Krasutski/mazda_tape_deck_emulator/(threads)

Thread 2 (2022-06-06):

Does the iPod support work with iPhones?

Shambler2, 2022-06-06:
Hiya,

I wanted to use this to add AuxIn to my 2004 Mx-5 (Mazdaspeed in the US).

I'd be happy with just basic Aux in but I noticed there's a sketch for iPod functionality.

Does this rely on the old 30-pin conenctor or could it function with the modern lightning connector also?

Cheers

Shambler2, 2022-06-06:
Ah okay I think I mis-understood how this was actually set up! This is emulating the button presses on a pair of wired headphones!

I'll build the circuit as described and give it a go, though can't see why it wouldn't work on a modern iPhone with the audio adapter, cheers!

Closed 2022-06-06.

Thread 3 (2025-06-14):

Finding a connector

jhahvhi, 2025-06-14:
Hello.
I'd like to try this in my car, a Mazda 2. I was actually thinking about doing it as a final project at university, adding Bluetooth to it. The problem is that if I want to do it for this purpose, it has to be done properly, including mounting it on a PCB, and for this I need a connector.
I found out on the internet what the connector for my radio looks like (probably the same as yours).
I'd like to know if you've been able to find a suitable connector and, if so, how you found it or where you got it. That would be very helpful.
Thank you.
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
