Krasutski/mazda_tape_deck_emulator/(commit log)

2016-07-15 Add timer for calculate delay Fix logs
2016-07-20 Added documentation on board Code refactoring
2016-07-20 Remove timer functionality from code
2016-07-20 Add support MIC pin on 3.5 jack for controll playing on audio device
2019-06-27 Update README.md
    орфография ;-)
    Кстати, опробовал схемку на Мазде Демио 2003 2 поколения - работала нормально, aux воспроизводился.
